alexbatista/single-cell-braille-controller/docs/README.md

# Firmware documentation

Developer documentation for the single-cell braille controller firmware. The
project overview, parts list, wiring and quick start are in the root
[README](../README.md); this folder explains how the firmware works and how to
change it.

## System in one paragraph

An STM32F103C8 (Blue Pill) polls a PLC over Modbus TCP through a W5500 Ethernet
controller, reading a package of boolean signals every 500 ms. A reader state
machine presents one signal at a time on a single braille cell: one or two
label letters, then the value as all dots flat or all raised. The cell is two
embossed discs, each turned by a NEMA17 stepper through a TMC2209 driver
(configured over UART, moved over STEP/DIR) and homed against a slotted IR
sensor. Three buttons navigate (NEXT, PREV, REPEAT) and a passive buzzer gives
audio feedback. Everything runs in a cooperative main loop without an RTOS. A
build option replaces the PLC path with characters typed over USB.

## Documents

| # | Document | Content |
|---|---|---|
| 1 | [Architecture](01-architecture.md) | Layers, modules, dependencies, core + port and callback-table patterns, build variants, CubeMX rules |
| 2 | [MCU resources](02-mcu-resources.md) | Clock tree, full pin map, peripherals, interrupt priorities, memory, silent failure paths |
| 3 | [Execution flow](03-execution-flow.md) | Reset to main loop, `App_init()`, `App_run()`, interrupts, blocking budget, one microstep traced to the registers |
| 4 | [TMC2209](04-tmc2209.md) | Module pinout, single-wire UART, configuration written at start-up, operating mode, library and port |
| 5 | [Motion and homing](05-motion-and-homing.md) | Units, stepper module, pulse trains, shortest-path moves, direction inversion, homing and its bounds |
| 6 | [Braille encoding](06-braille-encoding.md) | Dot numbering, positional binary mapping, glyph table, value glyphs, adding characters |
| 7 | [W5500](07-w5500.md) | SPI and port, bring-up, socket buffers, registers relied on, unused features, vendored library |
| 8 | [Modbus TCP and the PLC link](08-modbus-tcp.md) | Polling model, frames, strict parser, link state machine, `plc_config.h`, diagnosing the link |
| 9 | [Reader UI and buttons](09-reader-ui.md) | Reading model, labels, states and event table, pending slot, button debouncing |
| 10 | [Sound feedback](10-sound-feedback.md) | Buzzer circuit, tone generation, the five patterns, rate limits |
| 11 | [Adding a protocol](11-adding-a-protocol.md) | The seam, reusable modules, the link contract, build-time selection |
| 12 | [Porting to a new board](12-porting-to-a-new-board.md) | Pinout rules, fixed resources, PCB checklist, first power-up |
| 13 | [Build, test and debug](13-build-test-debug.md) | Toolchain, builds, flashing, live inspection, host tests, simulator, bring-up, blink codes, troubleshooting |
| 14 | [USB CDC bench variant](14-usb-cdc-variant.md) | USB input path and the UTF-8 decoder |
| — | [Known limitations](known-limitations.md) | Accepted gaps, technical debt, untested areas |
| — | [Design record: Modbus TCP reader](decisions/2026-09-09-modbus-tcp-braille-reader.md) | Archived design and its rationale |

## Reading paths

**Porting to a new board:** [2](02-mcu-resources.md) →
[12](12-porting-to-a-new-board.md) → [4](04-tmc2209.md) →
[7](07-w5500.md) → [3](03-execution-flow.md) →
[13](13-build-test-debug.md#138-bring-up-sequence).

**Adding a protocol:** [1](01-architecture.md) → [8](08-modbus-tcp.md) →
[11](11-adding-a-protocol.md) → [9](09-reader-ui.md).

**Fixing a bug:** [3](03-execution-flow.md) →
[13](13-build-test-debug.md#139-troubleshooting) → the subsystem document →
[known limitations](known-limitations.md).

## Conventions

- Code is referenced by file and symbol name (`plc_link.c`,
  `plc_link_tick()`), never by line number.
- Every number in these documents comes from a named constant or a
  configuration file; the constant is named next to the value.
- The generated API reference (`doxygen Doxyfile` → `docs/html/`, not tracked)
  documents the `App/` sources function by function.
- `images/wiring.svg` is generated by `tools/gen_wiring.py`.
