alexbatista/single-cell-braille-controller/hardware/enclosure/Passa cabo parte 1.stl

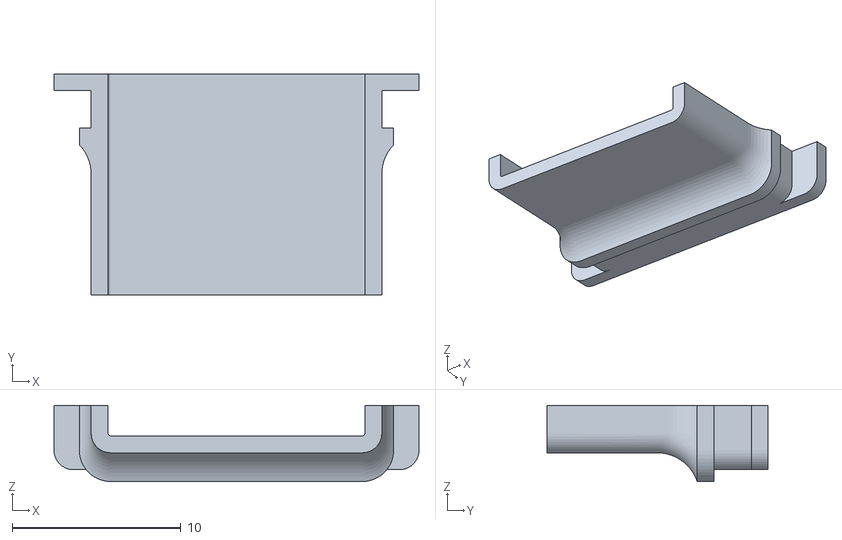
[picture p1: CAD file, 2026-10-16]
hardware/enclosure/Passa cabo parte 1.stl
21.6 x 13.1 x 4.50
