alexbatista/single-cell-braille-controller/hardware/enclosure/Passa cabo parte 2.stl

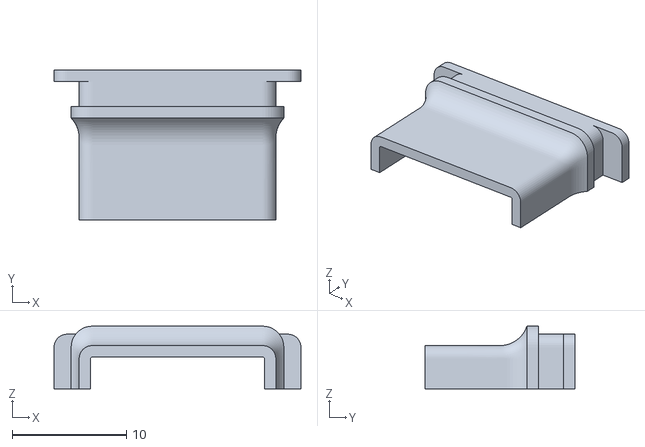
[picture p2: CAD file, 2026-10-16]
hardware/enclosure/Passa cabo parte 2.stl
21.6 x 13.1 x 5.48
