alexbatista/single-cell-braille-controller/hardware/enclosure/Embossed Disc 2 Row.stl

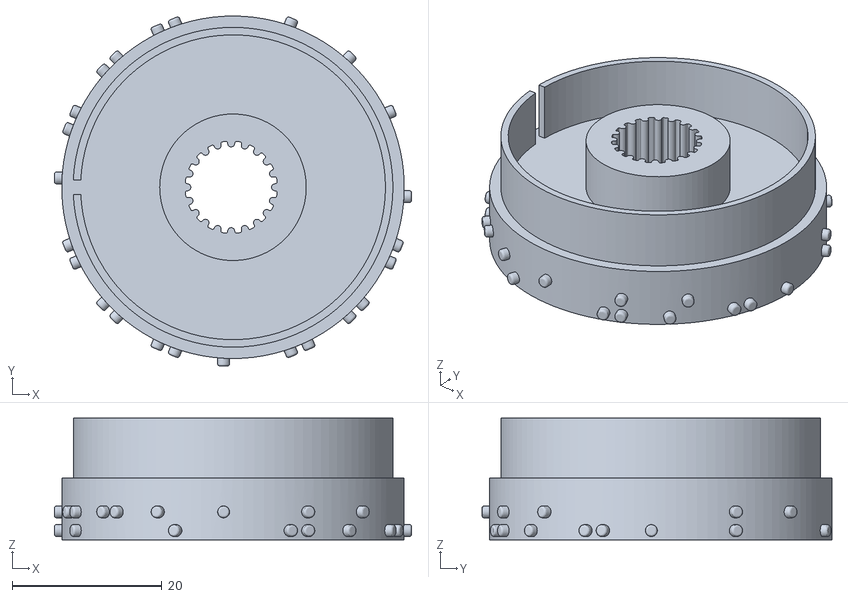
[picture p3: CAD file, 2026-10-16]
hardware/enclosure/Embossed Disc 2 Row.stl
47.8 x 46.8 x 16.3
