alexbatista/single-cell-braille-controller/hardware/enclosure/Tampa superior.stl

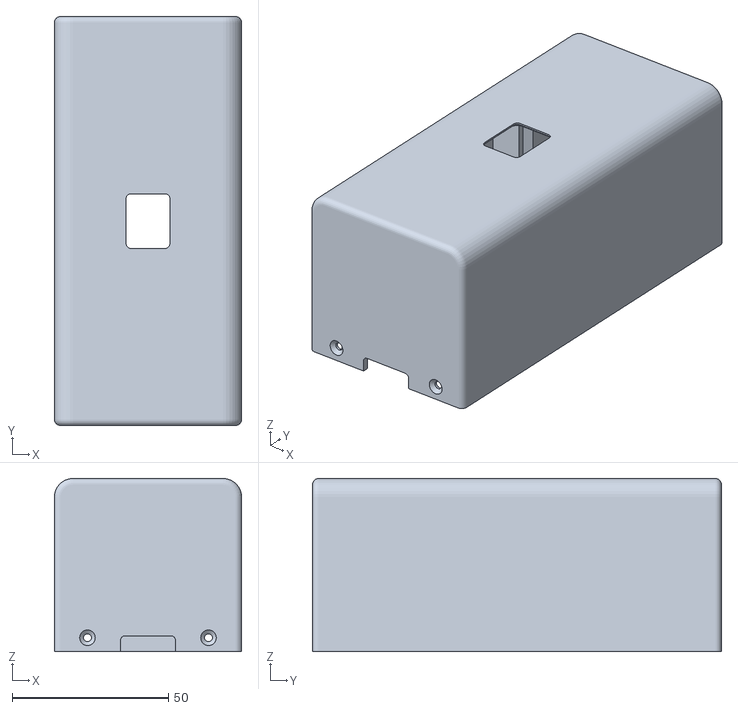
[picture p4: CAD file, 2026-10-16]
hardware/enclosure/Tampa superior.stl
60.0 x 130.9 x 55.4
