alexbatista/single-cell-braille-controller/hardware/enclosure/Embossed Disc 1 Row.stl

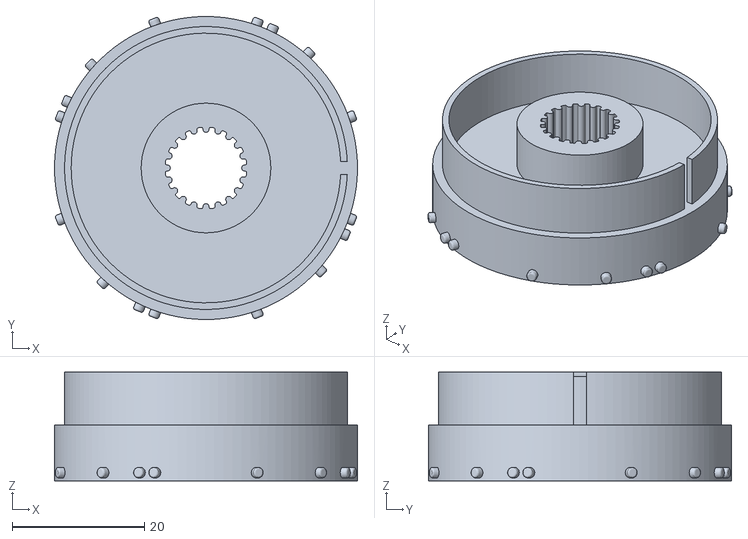
[picture p5: CAD file, 2026-10-16]
hardware/enclosure/Embossed Disc 1 Row.stl
45.8 x 45.8 x 16.5
