alexbatista/single-cell-braille-controller/hardware/enclosure/Tampa Inferior.stl

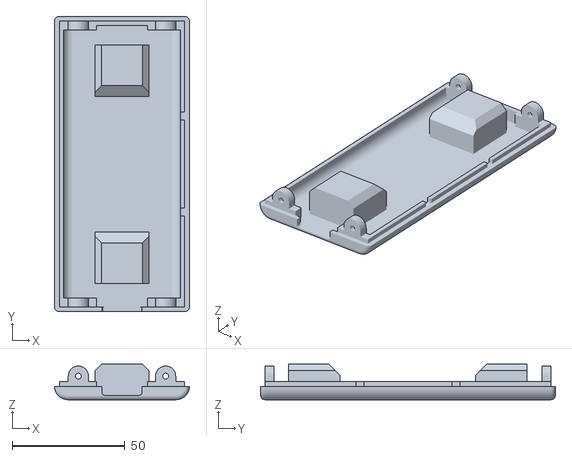
[picture p6: CAD file, 2026-10-16]
hardware/enclosure/Tampa Inferior.stl
60.0 x 130.9 x 15.8
