alexbatista/single-cell-braille-controller/single-cell-braille-controller.ioc

Mcu.UserName=STM32F103C8Tx
PA1.GPIO_Label=STEP_MOTOR01
PA1.Signal=S_TIM2_CH2
PA10.GPIO_Label=ETH_RESET
PA10.Signal=GPIO_Output
PA11.Signal=USB_DM
PA12.Signal=USB_DP
PA13.Signal=SYS_JTMS-SWDIO
PA14.Signal=SYS_JTCK-SWCLK
PA2.GPIO_Label=TX_TO_MOTOR01
PA2.Signal=USART2_TX
PA3.GPIO_Label=RX_TO_MOTOR01
PA3.Signal=USART2_RX
PA4.GPIO_Label=DIR_MOTOR01
PA4.Signal=GPIO_Output
PA5.GPIO_Label=ENABLE_MOTOR01
PA5.Signal=GPIO_Output
PA7.GPIO_Label=DIR_MOTOR02
PA7.Signal=GPIO_Output
PA8.GPIO_Label=ZERO_MOTOR02
PA8.Signal=GPIO_Input
PA9.GPIO_Label=ZERO_MOTOR01
PA9.Signal=GPIO_Input
PB0.GPIO_Label=ENABLE_MOTOR02
PB0.Signal=GPIO_Output
PB1.GPIO_Label=STEP_MOTOR02
PB1.Signal=S_TIM3_CH4
PB10.GPIO_Label=TX_TO_MOTOR02
PB10.Signal=USART3_TX
PB11.GPIO_Label=RX_TO_MOTOR02
PB11.Signal=USART3_RX
PB12.GPIO_Label=ETH_NSS
PB12.Signal=GPIO_Output
PB13.GPIO_Label=ETH_SPI2_SCK
PB13.Signal=SPI2_SCK
PB14.GPIO_Label=ETH_SPI2_MISO
PB14.Signal=SPI2_MISO
PB15.GPIO_Label=ETH_SPI2_MOSI
PB15.Signal=SPI2_MOSI
PB5.GPIO_Label=ETH_INT
PB5.Signal=GPXTI5
PB6.GPIO_Label=BUZZER
PB6.Signal=S_TIM4_CH1
PB7.GPIO_Label=BTN_REPEAT
PB7.Signal=GPXTI7
PB8.GPIO_Label=BTN_NEXT
PB8.Signal=GPXTI8
PB9.GPIO_Label=BTN_PREV
PB9.Signal=GPXTI9
PC13-TAMPER-RTC.GPIO_Label=LED
PC13-TAMPER-RTC.Signal=GPIO_Output
PD0-OSC_IN.Signal=RCC_OSC_IN
PD1-OSC_OUT.Signal=RCC_OSC_OUT
