alexbatista/single-cell-braille-controller/Core/Inc/main.h

#define LED_Pin GPIO_PIN_13
#define LED_GPIO_Port GPIOC
#define STEP_MOTOR01_Pin GPIO_PIN_1
#define STEP_MOTOR01_GPIO_Port GPIOA
#define TX_TO_MOTOR01_Pin GPIO_PIN_2
#define TX_TO_MOTOR01_GPIO_Port GPIOA
#define RX_TO_MOTOR01_Pin GPIO_PIN_3
#define RX_TO_MOTOR01_GPIO_Port GPIOA
#define DIR_MOTOR01_Pin GPIO_PIN_4
#define DIR_MOTOR01_GPIO_Port GPIOA
#define ENABLE_MOTOR01_Pin GPIO_PIN_5
#define ENABLE_MOTOR01_GPIO_Port GPIOA
#define DIR_MOTOR02_Pin GPIO_PIN_7
#define DIR_MOTOR02_GPIO_Port GPIOA
#define ENABLE_MOTOR02_Pin GPIO_PIN_0
#define ENABLE_MOTOR02_GPIO_Port GPIOB
#define STEP_MOTOR02_Pin GPIO_PIN_1
#define STEP_MOTOR02_GPIO_Port GPIOB
#define TX_TO_MOTOR02_Pin GPIO_PIN_10
#define TX_TO_MOTOR02_GPIO_Port GPIOB
#define RX_TO_MOTOR02_Pin GPIO_PIN_11
#define RX_TO_MOTOR02_GPIO_Port GPIOB
#define ETH_NSS_Pin GPIO_PIN_12
#define ETH_NSS_GPIO_Port GPIOB
#define ETH_SPI2_SCK_Pin GPIO_PIN_13
#define ETH_SPI2_SCK_GPIO_Port GPIOB
#define ETH_SPI2_MISO_Pin GPIO_PIN_14
#define ETH_SPI2_MISO_GPIO_Port GPIOB
#define ETH_SPI2_MOSI_Pin GPIO_PIN_15
#define ETH_SPI2_MOSI_GPIO_Port GPIOB
#define ZERO_MOTOR02_Pin GPIO_PIN_8
#define ZERO_MOTOR02_GPIO_Port GPIOA
#define ZERO_MOTOR01_Pin GPIO_PIN_9
#define ZERO_MOTOR01_GPIO_Port GPIOA
#define ETH_RESET_Pin GPIO_PIN_10
#define ETH_RESET_GPIO_Port GPIOA
#define BTN_NEXT_Pin GPIO_PIN_8
#define BTN_NEXT_GPIO_Port GPIOB
#define BTN_NEXT_EXTI_IRQn EXTI9_5_IRQn
#define BTN_PREV_Pin GPIO_PIN_9
#define BTN_PREV_GPIO_Port GPIOB
#define BTN_PREV_EXTI_IRQn EXTI9_5_IRQn
