alexbatista/single-cell-braille-controller/(commit log)

2026-05-29 Sets up clangd and CMake development environment
    Establishes comprehensive tooling for C/C++ development within VS Code.
    Integrates `clangd` for improved code analysis and IntelliSense by configuring the compilation database and specialized STM32CubeIDE clangd paths.
    Sets up CMake with Ninja as the preferred generator for the build system. Manages tool versions for CMake, Ninja, GNU tools for STM32, and ST-ARM clangd via bundle configuration files.
    Adjusts the main application loop delay from 500ms to 3000ms.
2026-06-03 Prioritizes complete ARM toolchains
    Updates the CMake toolchain file to search for and prioritize specific ARM toolchain installations.
    This addresses issues where default system toolchains (e.g., Homebrew's `arm-none-eabi-gcc`) may lack essential target headers and sysroot files, leading to broken STM32 builds. The build now probes for:
    - STM32CubeIDE bundled GNU toolchains
    - xPack `arm-none-eabi-gcc` installations (preferring the latest version)
    Using these known complete toolchains ensures a functional build environment with all necessary Newlib/sysroot components.
2026-07-07 Updates the pin mapping with the motor wiring on protoboard
2026-07-15 Drives both motors over STEP/DIR with a dedicated STEP_MOTOR01 pin
    Adds STEP_MOTOR01 on PA1 and moves DIR_MOTOR01 to PA4, gives the stepper
    module an optional enable pin, switches the tmc2209 STM32 port's enable
    pin argument from a raw pin number to a GPIO_PIN_x mask, and rewrites
    App_init/App_run to bring up both TMC2209 drivers over UART and pace
    their STEP pulses from the same loop instead of running motor 1 in
    VACTUAL mode.
2026-07-15 Adds study guides for the project's layering and TMC2209 usage
    Documents the CMSIS/HAL/Core/Lib/App layer stack, the boot-to-motion
    execution flow, the stepper module's core+port split, a practical
    TMC2209 function reference, and an evidence-based take on which parts
    of the current abstraction are earning their keep.
2026-07-17 Adjust the current percent to 40 instead of 80 at first
2026-07-22 Move motor control into motion planner and wire up disc translation
    Relocate all TMC2209/stepper setup and rotation logic from app_main.c
    into motion_planner.c, exposing it behind a small API: initialize_motors(),
    move_to_angle() and test_rotate_motor(). app_main.c is now just wiring:
    App_init() brings the motors up, App_run() translates a character and
    spins the test rotation.
    Add disk_angles_t (single/double row) to motion_planner.h to pass both
    disc angles together.
    braille_disc: rename move_*_row_disc to angle_*_row_disc so they return
    the computed angle instead of moving directly, and add the public
    translate_char_on_disc() (replacing Goto_character) which packs both
    angles and hands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
2026-07-23 Generate STEP pulses with timer PWM instead of bit-banging
    The stepper core drove STEP one edge at a time (Stepper_StepPulseBegin/End)
    and the motion planner paced every microstep against HAL_GetTick, so pulse
    timing depended on loop overhead and the CPU was tied up for the whole move.
    Move pulse generation into the timer hardware:
    - Stepper_Hal_t swaps step_write() for pulse_train_start(pulse_hz) /
    pulse_train_stop(). Callers ask for a step count at a rate with
    Stepper_MoveSteps() and poll Stepper_IsBusy(); the port raises
    Stepper_OnPulseComplete() once per emitted pulse, which is where the
    position is counted and the train is stopped on the last step.
    - The STM32 port holds a TIM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
2026-07-24 Implement character-to-disc-weight translation for braille cell
    Replace the braille_disc.c stubs with a working character-to-angle
    translation. Each character's 6 dots are stored once as a bitmask in a
    256-entry Latin-1-indexed table (the single source of truth), covering
    A-Z plus the Portuguese accented letters per the Brazilian standard
    "Grafia Braille para a Lingua Portuguesa" (IBC/MEC).
    - pattern_for_char() is the single encoding seam: folds ASCII and
    Latin-1 lowercase to uppercase, then looks up the pattern.
    - Each disc's weight is derived from that mask: disc 1 (dots 1,4) yields
    0..3, disc 2 (dots 2,3,5,6) yields 0..15 as [d6 d5 d3 d2].
    - Signatures switch from char to uint8_t so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
2026-07-25 Drive the braille cell from a USB CDC virtual COM port
    The board had no host link: App_run() rendered a hardcoded 'q' on every
    pass. Add a USB CDC (virtual COM port) device so characters typed on the
    host are what get translated onto the discs.
    - App_run() now pulls one byte with CDC_ReadChar(), echoes it back with
    CDC_Transmit_FS() so both directions are visible on the host terminal,
    toggles the LED, and feeds the byte to translate_char_on_disc(). No
    byte available means it returns immediately, so the loop stays free
    for the motion planner.
    - usbd_cdc_if: CDC_Receive_FS() copies each received packet into a
    single-producer/single-consumer ring buffer (head written only by the
    US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
2026-08-08 Add the zeroing routine and update the pin mapping on cubemx.
2026-08-15 Remove unused rotation helper function
    Deletes a redundant static function for executing full motor revolutions. This cleans up the codebase by removing dead code that is no longer required for motion planning or calibration.
2026-08-20 Implement robust homing and zero-point calibration
    Implements a multi-stage homing sequence that establishes a consistent zero reference for both discs. The new logic ensures accuracy by always approaching the sensor edge from the same direction, eliminating variability from sensor hysteresis or arrival speed.
    Adds bounded search limits to the homing process to prevent the system from hanging indefinitely in the event of a sensor failure or mechanical jam. Startup faults are now communicated via specific LED blink patterns for each motor, allowing for easier hardware diagnostics.
    Hardens the timer HAL by clamping pulse rates within the hardware's 16-bit limits, preventing potential overflo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
2026-08-20 Correct the mirrored disc rotation direction
    Both discs are geared so that the direction the TMC2209 drivers call forward
    turns them towards decreasing braille weight, so every rendered cell landed on
    the mirror image of its commanded angle. Typing 'a' raised dots 1 and 4 instead
    of dot 1, and 'b' raised all six dots instead of dots 1 and 2: the single-row
    disc commanded to 22.5 degrees settled on 337.5 degrees, which its
    four-position pattern repeats as 67.5 degrees, and the double-row disc did the
    same to land on position 15 with all four of its dots raised. The defect only
    became systematic once homing began assigning a known zero; before that the
    position counter started wherever the sea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
2026-08-20 Update documentation to reflect system-wide changes
    Refines architecture guides to include the USB middleware layer and the transition to a 48 MHz system clock required for USB operation.
    Documents the shift from software-paced step pulses to hardware-based PWM pulse trains, detailing how timers and interrupts handle step budgets and positioning.
    Replaces module placeholder descriptions with functional details for the motion planner and Braille decoder, clarifying their dependencies and roles in the application.
    Expands on the rationale for the core/port abstraction pattern, highlighting its value in off-target testing and handling hardware-specifics like mirrored motor gearing.
    Updates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
2026-09-09 feat: Add a new SPI connection for the W5500 module to use MODBUS TCP
2026-09-09 feat: add mapping of new pins: buttons and buzzers
2026-09-10 docs: design for the MODBUS TCP braille reader
    Records the approved design for replacing USB-typed-character input with a
    PLC data source: the device reads a fixed 11-coil package from the PLC over
    MODBUS TCP and renders it one key/value pair at a time on the single braille
    cell, navigated by the three new buttons and narrated by the buzzer.
    The design turns on four constraints. Flash is the binding one: the Debug
    build already occupies 71% of the 64 KB part, so the USB device stack has to
    be compiled out of the MODBUS variant to make room for ioLibrary -- the
    compile-time input switch is load-bearing, not cosmetic. move_to_angle()
    blocks for roughly a second, which forces every other conce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
2026-09-10 docs: correct the flash budget premise in the MODBUS TCP design
    Measuring both presets before planning showed the design was built on a
    misreading. The 46 532 B / 71% figure that motivated the flash-pressure
    argument is the Debug build at -O0 -g3. Release, at -Os with the
    --gc-sections that were already enabled, is 22 068 B -- 33.7% of the 64 KB
    part, with 43 468 B free. There is no flash crisis, and ioLibrary plus the
    new modules fit either preset comfortably.
    Compiling the USB stack out of the MODBUS variant survives the correction,
    but its justification changes: it is about build hygiene and keeping the -O0
    Debug build roomy, not about making the feature fit. USB is over half the
    Debug i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
2026-09-10 docs: implementation plan for the MODBUS TCP braille reader
    Thirteen tasks in three phases, each ending in an independently testable
    deliverable and a commit.
    Phase 1 is pure logic with a committed host test harness, which formalises the
    throwaway gcc-plus-HAL-stub technique from earlier sessions. Everything the
    reader does -- the cursor, the pending slot, the dwell sequencing, the whole
    event table -- is pinned down and verified before any hardware is involved.
    That ordering is the point rather than a preference: checking eleven-field
    navigation on real discs costs about 45 seconds per attempt, so the
    end-of-package and pending-slot paths would be nearly untestable on target.
    Phase 2 port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
2026-09-10 docs: pre-flight fixes to the MODBUS TCP plan and spec
    Scanning the plan for cross-task conflicts before dispatching anything turned
    up two defects that would have stopped execution and three smaller ones.
    The two blocking ones. Every host suite includes its module's .c directly to
    reach static functions, but the test Makefile's include path covered only
    App/Inc, so none of them could have compiled. And the build-variant task ran
    before integration, which cannot work: dropping USB from the link while
    app_main.c still calls CDC_ReadChar and CDC_Transmit_FS leaves unresolved
    symbols. The two tasks are swapped, so integration writes the #if gating first
    and the variant switch follows -- with n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
2026-09-10 refactor: move blink_warning into a shared fault_led module
    blink_warning() was static in motion_planner.c because the two motors were
    its only callers. The Ethernet link is a third caller, so the function and
    its blink-code constants move to fault_led.c rather than being duplicated.
    Putting the codes in one header is the point: motor 01 is 1, motor 02 is 2,
    Ethernet is 3, and a future subsystem cannot quietly reuse a number. docs/04
    already notes that these patterns are only readable by eye while they stay
    small and distinct.
    Pure move, no behaviour change; the active-low LED write order is preserved
    verbatim. Release text 21708 B.
2026-09-10 feat: add plc_config.h with the deployment settings
    One home for every number an installation might change: this device's static
    identity, the PLC endpoint (port 503, not the 502 default), the coil range,
    and the reader and link timings. Nothing here is discovered at runtime -- the
    design chose static configuration over DHCP so there is no boot path that can
    stall waiting for a server that never answers.
    Splitting the addresses into per-octet macros rather than strings keeps them
    usable directly as the uint8_t[4] arrays ioLibrary's wiz_NetInfo expects, with
    no parsing on the device.
2026-09-10 feat: add the MODBUS TCP Read Coils codec
    Framing only -- the caller owns the socket. Keeping the codec free of I/O is
    what makes the parser's rejection paths reachable from a host test with a
    hand-built byte array, which is the only practical way to cover them.
    The parser is deliberately strict about two things that are easy to get wrong
    and silent when wrong. A reply carrying an earlier transaction id would hand
    the reader stale coil states with nothing to indicate a problem, so the id is
    checked as carefully as the framing and the MBAP length field is required to
    agree with the bytes that actually arrived. And bits above the requested
    quantity are masked off, so a slave that pads its las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
2026-09-10 fix: modbus_tcp error handling and test coverage
    FINDING 1: MODBUS_ERR_TOO_SHORT was returned for invalid arguments (null
    pointers, out-of-range quantity), which is misleading since it claims "fewer
    bytes than any legal response" — a wire-level issue. Add MODBUS_ERR_INVALID_ARGUMENT
    at the end of the enum and return it from the argument validation guard instead.
    FINDING 2: The final truncation check (length < MODBUS_READ_COILS_RSP_LEN)
    after byte-count validation had no test. Add a test case constructing a frame
    that passes all earlier checks but fails this one: length 10, MBAP field 4,
    byte count 2 (promising 2 bytes but delivering only 1).
    - App/Inc/modbus_tcp.h: add MODBUS_ERR_INVALID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
2026-09-10 feat: add the reader UI state machine
    One press of NEXT plays a whole item -- label glyphs, then the value as all
    dots flat or all raised -- and the cell rests on the value so the reader ends
    with a finger on the answer. Dwell is measured from after the render returns,
    because on hardware the render blocks while the discs turn.
    The module reaches hardware only through a struct of function pointers, which
    is the point of the decomposition: verifying eleven-field navigation on real
    discs costs about 45 seconds per attempt, so the test drives the machine with
    a fake clock and compares whole sequences of side effects encoded one
    character each. "AE-" is a full item.
    Three behaviours are delibe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
2026-09-10 feat: add the buzzer tone-pattern player
    Five notification patterns on TIM4_CH1. The timer arrives from CubeMX with a
    1 MHz counter tick, so pitch is just a period and the module only ever
    rewrites ARR and CCR.
    The patterns are separated by texture as much as by pitch, because two sounds
    that differ only in frequency are hard to tell apart on a small piezo:
    'asking' is a rising pair, 'received' is one longer tone, 'data is waiting' is
    a fast triple chirp, and a fault is a slow low double -- deliberately the
    longest pattern of the five.
    buzzer_play() blocks, which is the one deliberate exception to the otherwise
    cooperative design. PWM keeps sounding in hardware with no software
    involvement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
2026-09-10 feat: add debounced navigation buttons
    The three buttons share one EXTI group, so the interrupt only records that a
    press happened and the main loop collects it.
    Debouncing is 'first edge wins, then lock out' rather than a settle-and-poll:
    the press registers on the very first edge, which matters for a control the
    reader works by feel, and further edges inside the 40 ms window are discarded
    as contact bounce. No polling loop is needed.
    Each button holds one flag rather than a count, deliberately. A disc move
    blocks for roughly a second, and a reader who taps NEXT three times during one
    means 'move on', not 'skip three fields'.
    Read-and-clear masks interrupts around the test-and-clear pair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
2026-09-10 feat: vendor WIZnet ioLibrary and port it to SPI2
    Only the Ethernet tree is copied: wizchip_conf, socket, and the W5500
    register layer. The whole Internet/ tree is deliberately absent -- this
    device has a static address and speaks nothing but MODBUS TCP, so DHCP,
    DNS, SNTP, HTTP and FTP would be dead code on a 64 KB part. UPSTREAM.md
    records the commit fetched (39fae86465dbaa728107c3b2a90692c0a1639735) and
    every local modification -- there are none: this revision already guards
    both _WIZCHIP_ and _WIZCHIP_IO_MODE_ with #ifndef, so the CMake -D flags
    take effect without touching the vendored source.
    The brief was written against WIZnet's documentation rather than this
    source, so every assump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
2026-09-10 feat: add the MODBUS TCP link state machine
    The device polls continuously as a client, because MODBUS gives a server no
    way to push. That is the whole mechanism behind 'the PLC sent something
    unrequested': a background poll comes back different from what the reader is
    holding, and the newer package is offered to them.
    Everything is driven from plc_link_tick() and returns immediately, with one
    exception: bringing the chip out of reset blocks for about 12 ms. It runs at
    startup and on a reconnect attempt, never while the reader is mid-package, so
    a timed state machine there would be complexity with nothing to show for it.
    Every failure funnels through one fail_to_backoff() path, so the recov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
2026-09-10 fix: report link faults on a bare cable and drain desynced replies
    Task 10 review, fix round 1: three error-handling gaps in plc_link, all in
    paths the original brief did not fully specify.
    A cold boot with the W5500 fitted but no cable plugged in went straight to
    PLC_LINK_LINK_WAIT and stayed silent forever -- the header promises on_fault
    for "no cable" but nothing ever called it, and the state's own comment
    wrongly claimed the reader had already been told once. LINK_WAIT now reports
    roughly every PLC_RECONNECT_DELAY_MS while the PHY link stays down, relying
    on reader_ui's existing rate limiter to bound how often that actually
    sounds.
    The bigger gap was TCP stream desync. read_response()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
2026-09-10 feat: drive the braille cell from the PLC over MODBUS TCP
    App_run() becomes a cooperative tick: buttons first, because they are the only
    thing a person is waiting on; the link next, so a poll goes out as soon as it
    is due; the sequencer last, since its work is timer-driven. Only two calls in
    the loop block, both bounded -- a disc move of about a second and a buzzer
    pattern of up to 480 ms -- and presses stay latched by their interrupt
    throughout.
    The wiring turned out to be two initialiser tables and nothing else. Every
    signature already lines up, so no adapter functions sit between the reader,
    the renderer, the buzzer and the link -- which is the payoff for defining the
    reader's IO as func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
2026-09-10 docs: stop the plan's commit templates from asserting unrun hardware checks
    The Task 11 review caught this in the plan rather than in the code. Tasks 9
    and 11 carried commit-message templates that state hardware verification as
    fact -- "Verified on hardware by reading VERSIONR as 0x04" and "Verified end to
    end against the PLC" -- but both sit in tasks whose bench steps need a board
    and a live PLC. This session had neither, so both steps were deliberately
    skipped, and both implementers correctly wrote their own honest message instead
    of pasting the template. A future run of this plan might not.
    Both templates now offer the two wordings in angle brackets with an instruction
    to pick the true o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
2026-09-10 build: select the input source at configure time
    BRAILLE_INPUT=MODBUS (the default) or USB_CDC. The MODBUS variant drops the
    USB application sources and the class-stack middleware from the link; the USB
    variant rebuilds the typed-character firmware unchanged, which is worth
    keeping for bench work on the braille rendering with no PLC in the room.
    The switch lives in the top-level CMakeLists.txt, not in
    cmake/stm32cubemx/CMakeLists.txt, because the latter is regenerated by CubeMX
    and any edit there is temporary by construction.
    Two references to USB survive in generated code and cannot be guarded:
    main() calls MX_USB_DEVICE_Init(), and stm32f1xx_it.c's USB handler calls
    HAL_PCD_IRQHandler(&h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
2026-09-10 docs: document the MODBUS TCP reader
    Two new guides and four updates. The guides explain what the code does and
    why it has to work that way, matching the voice of the existing eight rather
    than reading as a changelog.
    docs/09 leads with the thing most likely to confuse someone who read the
    original requirement: the device is a MODBUS client, a server cannot push to
    a client, and 'the PLC sent something unrequested' is really 'a background
    poll came back different'. It also spells out why the parser is strict, since
    a reply to an earlier request decodes perfectly and would show wrong values
    with nothing to indicate a problem.
    docs/10 covers the reading model and the invariant the label sche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
2026-09-11 docs: record the known backlog alongside the bring-up checklist
    Four items were raised during review and judged not worth fixing at the time.
    They lived only in the execution ledger, which is scratch and about to be
    deleted, so the reasoning would have died with it -- leaving four findings that
    someone eventually rediscovers from scratch without knowing they were already
    weighed.
    The one worth knowing about before bring-up is plc_link's poll_requested flag
    surviving a reader-side timeout, which can attribute a reply to the wrong cause
    on an already-failing link. It changes a sound, not data, and fixing it would
    have one module reach into the other's state on a path neither owns.
    None of th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
2026-09-11 tools: add a PLC simulator and the host-side network checklist
    The board is flashed but nothing has been on a wire yet, and the obvious way
    to look for it does not work: the firmware is a MODBUS client with no
    listening socket anywhere, so a port scan finds nothing open and reports a
    healthy board as a dead one. The new docs/11 section leads with that, because
    it is the conclusion someone reaches in the first five minutes otherwise.
    The single most informative observation turns out to be an ARP request. With
    no PLC answering, the W5500 has no destination MAC and therefore cannot emit
    its SYN, so the device sits repeating "who-has 10.0.0.204". That one line
    proves the chip is alive over SPI,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
2026-09-11 docs: start the network checklist at the board, not at the host
    The previous version failed on first real use. Following it produced arping
    timeouts, a FAILED neighbour entry, and a tcpdump in which every captured
    packet came from the site router -- nothing from the board at all. The guide
    had no way to tell "on the network and silent" apart from "not running the
    code that speaks network", which is the distinction that actually mattered.
    So the checklist now starts before any PC is involved. The discs home at
    power-up, ahead of anything Ethernet, so motors that do not move mean the MCU
    is not executing this firmware and no amount of tcpdump will reveal it. The
    three blink codes are spelled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
2026-09-11 fix(w5500): make recv() test for data before the non-blocking flag
    Upstream's recv() checks the non-blocking flag first and only then whether any
    data arrived. SOCK_BUSY is 0, so on a socket opened with SF_IO_NONBLOCK this
    returns 0 unconditionally -- with a complete frame already sitting in the RX
    buffer. Any caller that treats a non-positive return as an error then destroys
    a perfectly healthy connection on every single read.
    That is what happened here. The device connected, polled, received a valid
    MODBUS reply and sent an RST roughly 200 ms later, once per poll, indefinitely.
    Everything at the MODBUS layer was provably correct, which is exactly what made
    it hard to place: the symptom po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
2026-09-11 fix: survive a read that consumes nothing, and record the bench findings
    Companion to the ioLibrary recv() fix. Tearing down a connection because a read
    consumed nothing was wrong on its own terms, independently of the library
    defect that made it fire every time: the bytes are still queued, the socket is
    still established, and the caller's response timeout already bounds how long a
    stall can go on. read_response() now retries on the next tick and reserves
    fail_to_backoff() for a genuinely negative return.
    Two documented findings, both from the bench and neither obvious from the code:
    docs/09 gains a section on the healthy-socket-that-refuses-to-read failure --
    what it looks like from the s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
2026-09-11 fix: announce a queued package on the edge, and drop it when the line returns
    The device beeped every five seconds on the bench. That was PACKAGE_QUEUED,
    spaced by PLC_QUEUED_SOUND_MIN_INTERVAL_MS, because the announcement was
    level-triggered rather than edge-triggered: reader_ui_on_snapshot compares each
    poll against the package the reader holds, so once the line differs, every
    background poll -- twice a second -- reached that branch and the limiter let one
    chirp through every five seconds until adoption. With the simulator changing a
    coil once a minute, that is twelve announcements of a fact the reader learned
    on the first one.
    "Newer data is waiting" is one bit. Repeating it adds nothing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
2026-09-11 docs: answer in 10.0 the three questions real use actually raised
    Three questions came up after a bench session: how often the PLC is asked, when
    the chirp actually plays, and what NEXT does at the last field when nothing new
    is waiting. All three turned out to be answered by the code, and none needed a
    behaviour change -- the design stands. That they had to be asked at all is the
    finding, because they came from someone who had already read the code and used
    the device, which is exactly the reader this guide is written for.
    The poll interval was documented, but in 09 rather than here; someone wondering
    about the reading cadence looks in the reader's guide, not the link's. The chirp
    conditio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
2026-09-11 fix: debounce the button release, not just the press
    A single press was sometimes read as two. The debounce measured a 40 ms
    lockout from the accepted press, which covers the bounce as the contact
    closes -- and has always expired by the time the operator lets go.
    A mechanical contact bounces when it opens as much as when it closes, and
    these buttons interrupt on the falling edge only, so releasing produces
    further falling edges. They arrive however long after the press the operator
    chose to hold, which is precisely why no window measured from the press can
    cover them: the hold time is not the firmware's to pick. Raising the number
    would have moved the failure, not removed it -- hold the but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
2026-10-16 docs: add project README, MIT license and wiring diagram
2026-10-16 fix: correct comments that describe the pre-hardware-timer design
    Motion comments still described both motors stepping in lockstep from one
    paced loop, and the blocking budget quoted moves of about a second. Each
    motor has its own STEP timer and a move is at most half a turn (~0.5 s).
    The button comments now say what buttons.c does: the first press during a
    block is latched, repeats before release collapse into it.
2026-10-16 fix: derive the buzzer timer tick from the clock tree
    The buzzer hardcoded a 1 MHz counter tick, which silently detunes every
    pattern if the clock tree or TIM4 prescaler changes on a new board. The
    tick is now read at init the same way stepper_hal.c derives the STEP
    timers' tick. At the current clock it is unchanged:
    PCLK1 24 MHz x 2 / (PSC 47 + 1) = 1 000 000 Hz.
2026-10-16 build: remove the unused duplicate linker script
    STM32F103xx_FLASH.ld differed from STM32F103XX_FLASH.ld only in case of the
    name (plus symbol placement), which collides on case-insensitive file
    systems. Both CMake toolchain files link with the uppercase one.
2026-10-16 docs: let Doxygen document the default MODBUS build
    app_main.c and the modules it wires are guarded by BRAILLE_INPUT_MODBUS /
    BRAILLE_INPUT_USB_CDC, which CMake defines but Doxygen did not, so the
    conditional code was invisible to the generated reference.
2026-10-16 docs: drive the buzzer through a BC368 from 5 V and use BTT TMC2209 pin names in the wiring diagram
    The passive piezo is low-side switched by a BC368 NPN (PB6 -> 1 kOhm ->
    base, emitter to GND, collector to buzzer -, buzzer + to the 5 V rail of
    the power breakout). The diagram gains that 5 V rail and the transistor
    stage, and the TMC2209 boxes use the BIGTREETECH V1.2 silkscreen names
    (VCC_IO, PDN) with a note that the UART is on J1 pin 4 by default. The
    generator moves into tools/ so the diagram can be regenerated when the
    pinout changes. README parts list, power tree and pin table follow.
2026-10-16 docs: add execution flow reference
2026-10-16 docs: add TMC2209 and motion/homing references
    Also corrects the pulse_train_stop() comment in stepper_hal.c: stopping
    the channel does not hand the pin back to the GPIO output register (it
    stays in alternate-function mode); the disabled timer output drives it low.
2026-10-16 docs: add guides for adding a protocol and porting to a new board
2026-10-16 docs: fix review findings in the bring-up sequence, buzzer API and power notes
    - The first package is fetched by the background poll and announced with
    the confirm tone; NEXT then shows field 0 without a request. The
    bring-up step and the README power-up steps said otherwise.
    - buzzer_init()'s comment still required a fixed 1 MHz tick; it now states
    the real precondition (timer initialised, lowest tone fits 16 bits).
    - USB bench variant: say how to power it with the 12 V supply connected.
    - Compiler version, Doxygen caller graphs, a self-contradicting timeout
    note and the request-flag limitation corrected; collector wire in the
    wiring diagram no longer drawn in the GND colour.
2026-10-16 docs: fix the Blue Pill bottom header order in the wiring diagram
    The bottom header runs GND, GND, 3V3, R, B11 ... C13, VB starting at the
    USB end, not the reverse. With the corrected order motor 02's pins sit
    nearer the USB end, so the motor 02 driver and motor now sit on the left
    and motor 01 on the right; the pin assignments themselves are unchanged.
2026-10-16 docs: drop the LDO heat note from the wiring diagram
    The README's power section already carries this warning.
2026-10-16 docs: build with Ninja and flash with the full STM32CubeProgrammer command
    Document the workflow actually used: configure once with the CMake
    preset, then run ninja in the build directory; flash with
    STM32_Programmer_CLI -c port=SWD speed=4000 -e all -w <elf> 0x08000000 -s,
    with each option explained.
2026-10-16 add stl files for the enclosure
2026-10-16 docs: describe the enclosure and disc STL files in the README
2026-10-21 docs: set the SWD clock with freq=, not speed=, in the flash command
    STM32CubeProgrammer takes the SWD frequency as freq=<kHz>; speed= only
    selects Reliable/fast flashing on STM32U5 and is rejected on the F103.
2026-10-22 docs: leave TMC2209 MS1/MS2 open in the wiring diagram
    The prototype does not wire MS1/MS2; the chip's internal pull-downs
    still select UART address 0.
